DeMarco/DMH-BBDelay/Simulations/ch B.jpg

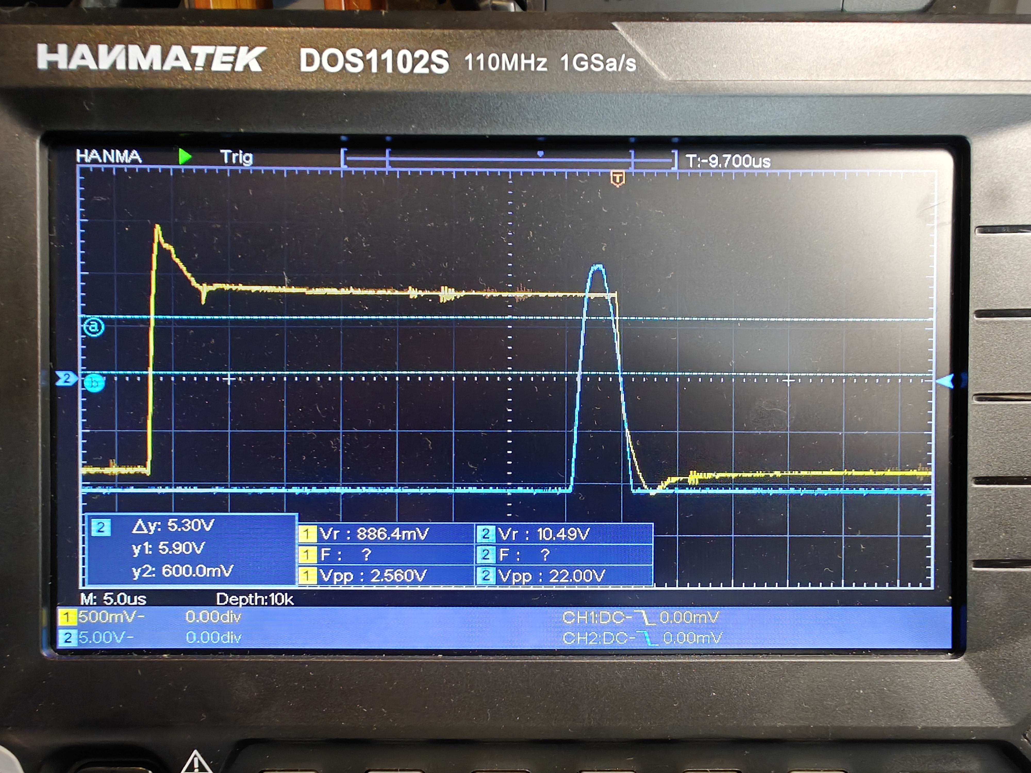
Simulations/ch B.jpg
