DeMarco/DMH-BBDelay/Simulations/ch A.jpg

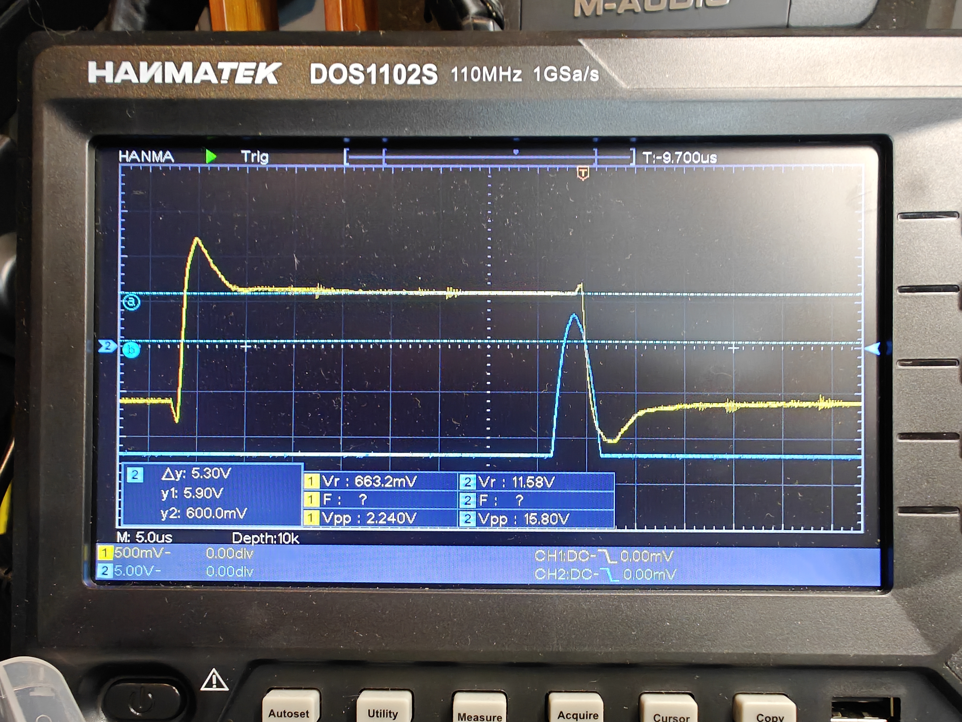
Simulations/ch A.jpg
