DeMarco/DMH-BBDelay/README.md

# DMH-BBDelay
Bucket Brigade Delay in Kosmo Format
