DeMarco/DMH-BBDelay/Simulations/ch A 2.jpg

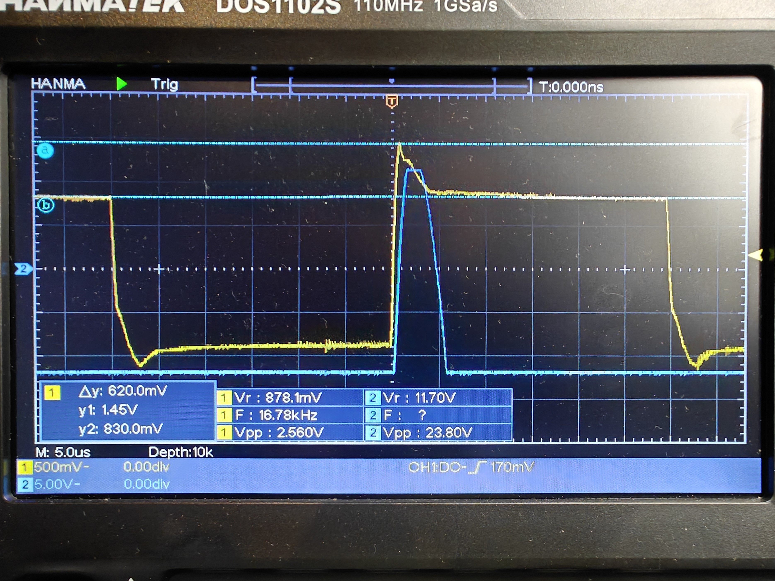
Simulations/ch A 2.jpg
