DeMarco/DMH-BBDelay/Simulations/ch B 2.jpg

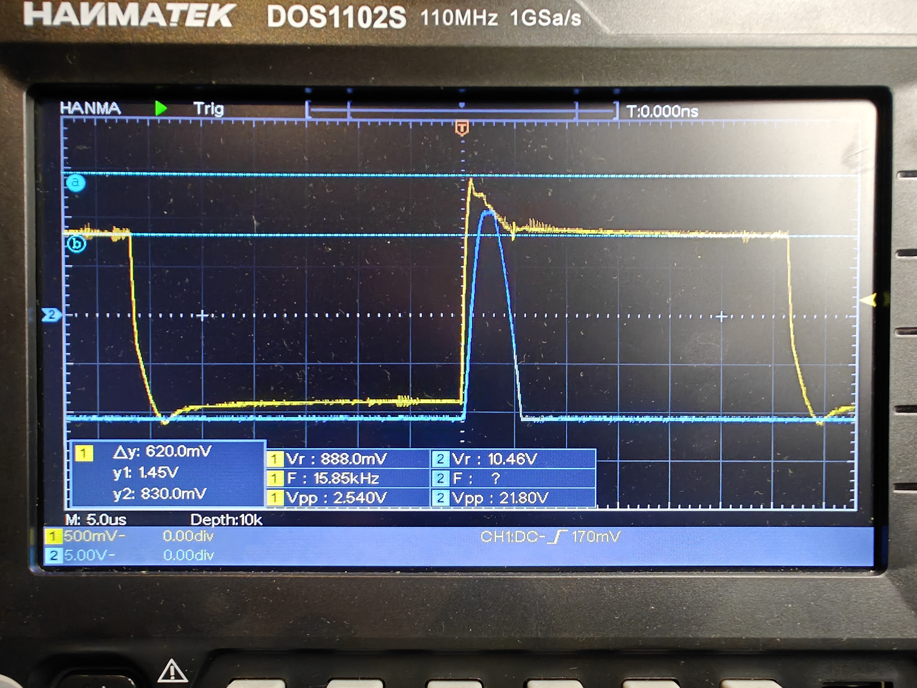
Simulations/ch B 2.jpg
