DeMarco/DMH-BBDelay/DMH_BBDelay_PCB_Main/DMH_BBDelay_PCB_Main.kicad_pcb

## KiCad design DMH_BBDelay_PCB_Main/DMH_BBDelay_PCB_Main.kicad_pcb (2026-11-13)

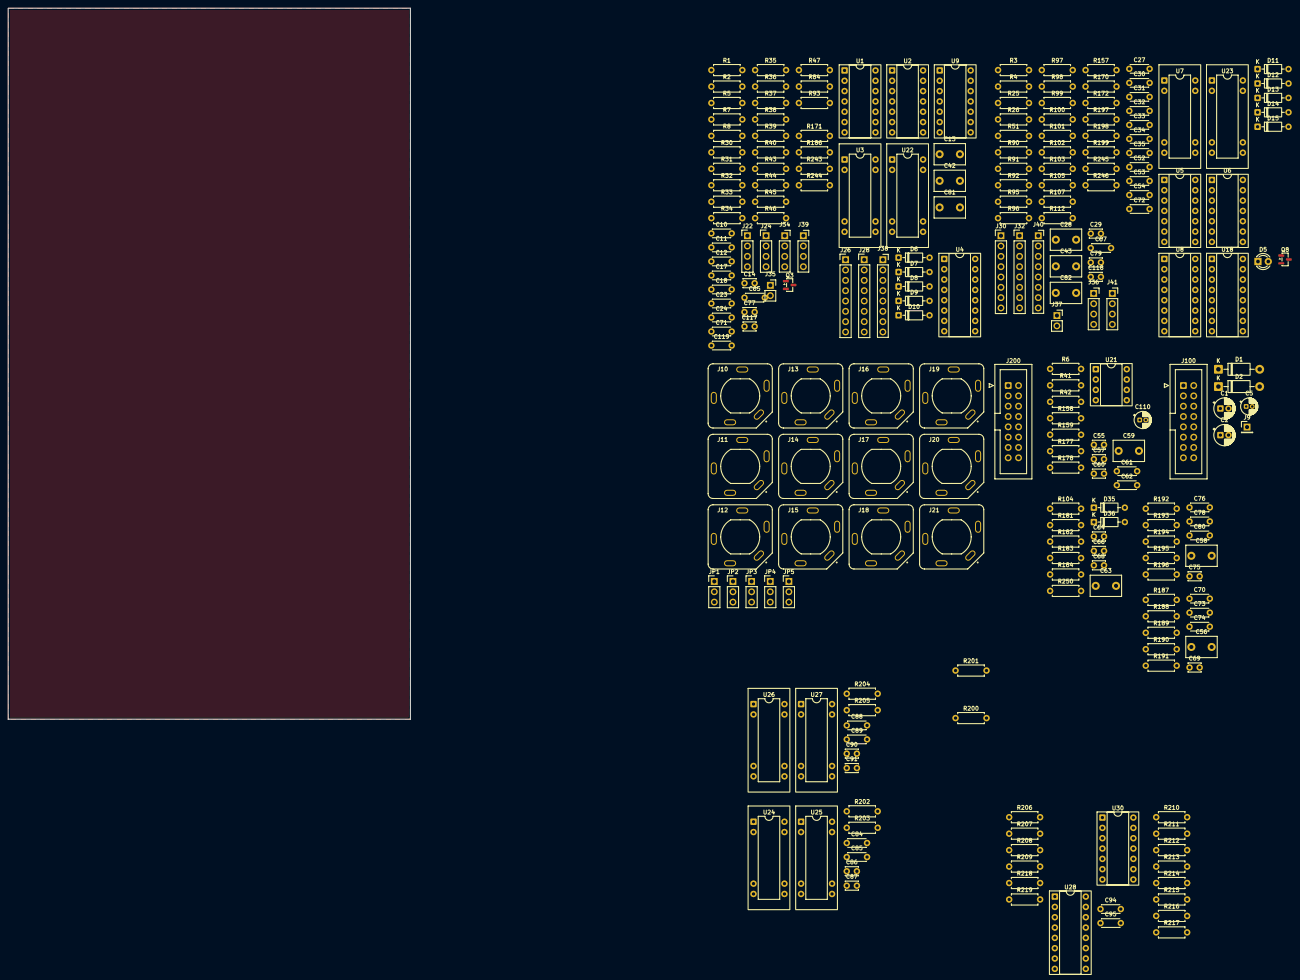
[picture p5: board DMH_BBDelay_PCB_Main.kicad_pcb from above]

Board: 2 copper layers, 99.0 x 175.0 mm, 236 parts (0 on the bottom side), 160 nets, no tracks yet.

Parts:
C1, C2: 47uF; CP_Radial_D5.0mm_P2.00mm
C5: 47uF; CP_Radial_D4.0mm_P1.50mm
C10, C11, C12, C18, C23, C24, C27, C30, C31, C33, C34, C35, C52, C53, C54, C61, C62, C65, C67, C71, C72, C84, C85, C88, C89, C94, C95: 100nF; C_Disc_D4.3mm_W1.9mm_P5.00mm
C13, C28, C42, C43, C56, C58, C59, C63, C81, C82: 1uF Film; C_Disc_D7.5mm_W5.0mm_P5.00mm
C14, C29: 220pF; C_Disc_D3.0mm_W2.0mm_P2.50mm
C17, C32: 15nF; C_Disc_D4.3mm_W1.9mm_P5.00mm
C55, C68: 150p; C_Disc_D3.0mm_W2.0mm_P2.50mm
C57, C60, C64, C66: 1.5nF; C_Disc_D3.0mm_W2.0mm_P2.50mm
C69, C75: 100p; C_Disc_D3.0mm_W2.0mm_P2.50mm
C70, C80: 1.5nF; C_Disc_D4.3mm_W1.9mm_P5.00mm
C73, C74, C76, C78: 1nF; C_Disc_D4.3mm_W1.9mm_P5.00mm
C77, C79, C86, C87, C90, C91: 470pF; C_Disc_D3.0mm_W2.0mm_P2.50mm
C110: 4.7uF; CP_Radial_D4.0mm_P1.50mm
C117, C118: 100pF; C_Disc_D3.0mm_W2.0mm_P2.50mm
C119: 3.3uF; C_Disc_D4.3mm_W1.9mm_P5.00mm
D1, D2: 1N5819; D_DO-41_SOD81_P10.16mm_Horizontal
D5: LED_Blue; LED_D3.0mm
D6, D15, D35, D36: 1N4148; D_DO-35_SOD27_P7.62mm_Horizontal
D7, D10, D12, D14: ZPD5v1; D_DO-35_SOD27_P7.62mm_Horizontal
D8, D9, D11, D13: BAT85; D_DO-35_SOD27_P7.62mm_Horizontal
J9: Conn_01x01; PinHeader_1x01_P2.54mm_Vertical
J10, J11, J12, J13, J14, J15, J16, J17, J18, J19, J20, J21: TRS_Jack_6.35mm_Sw; CUI_SJ-63083D
J22, J24: Conn_01x04; PinHeader_1x04_P2.54mm_Vertical
J26, J28, J30, J32: Conn_01x08; PinHeader_1x08_P2.54mm_Vertical
J34, J36, J39, J41: Conn_01x04; PinSocket_1x04_P2.54mm_Vertical
J35, J37: Conn_01x02; PinSocket_1x02_P2.54mm_Vertical
J38, J40: Conn_01x08; PinSocket_1x08_P2.54mm_Vertical
J100: IDC_02x08; IDC-Header_2x08_P2.54mm_Vertical_Eurorack
J200: IDC_02x08; IDC-Header_2x08_P2.54mm_Vertical_BackBone
JP1, JP2, JP3, JP4, JP5: Jumper_3_Bridged12; PinHeader_1x03_P2.54mm_Vertical
Q3, Q8: J113; SOT-23
R1, R3: 220k; R_Axial_DIN0207_L6.3mm_D2.5mm_P7.62mm_Horizontal
R2, R4, R5, R6, R25, R32, R33, R34, R37, R95, R96, R97, R101, R104, R170, R171, R172, R178, R183, R218, R219, R243, R246: 100k; R_Axial_DIN0207_L6.3mm_D2.5mm_P7.62mm_Horizontal
R7, R90: 3k3; R_Axial_DIN0207_L6.3mm_D2.5mm_P7.62mm_Horizontal
R8, R26: 2k2; R_Axial_DIN0207_L6.3mm_D2.5mm_P7.62mm_Horizontal
R30, R157: 4k7; R_Axial_DIN0207_L6.3mm_D2.5mm_P7.62mm_Horizontal
R31, R159, R182: 56k; R_Axial_DIN0207_L6.3mm_D2.5mm_P7.62mm_Horizontal
R35, R99: 5k6; R_Axial_DIN0207_L6.3mm_D2.5mm_P7.62mm_Horizontal
R36, R40, R44, R45, R51, R98, R102, R105: 10k; R_Axial_DIN0207_L6.3mm_D2.5mm_P7.62mm_Horizontal
R38: 14k; R_Axial_DIN0207_L6.3mm_D2.5mm_P7.62mm_Horizontal
R39, R92: 1M; R_Axial_DIN0207_L6.3mm_D2.5mm_P7.62mm_Horizontal
R41, R42, R200, R201, R202, R203, R204, R205, R244, R245: 20k; R_Axial_DIN0207_L6.3mm_D2.5mm_P7.62mm_Horizontal
R43, R84, R100, R112, R250: 1k; R_Axial_DIN0207_L6.3mm_D2.5mm_P7.62mm_Horizontal
R46, R47, R91, R103, R107, R189, R195: 39k; R_Axial_DIN0207_L6.3mm_D2.5mm_P7.62mm_Horizontal
R93: 15k8; R_Axial_DIN0207_L6.3mm_D2.5mm_P7.62mm_Horizontal
R158, R181: 47k; R_Axial_DIN0207_L6.3mm_D2.5mm_P7.62mm_Horizontal
R177, R184, R188, R196, R197, R207, R209, R211, R213, R215: 33k; R_Axial_DIN0207_L6.3mm_D2.5mm_P7.62mm_Horizontal
R186, R206, R208, R210, R212, R214: 6k8; R_Axial_DIN0207_L6.3mm_D2.5mm_P7.62mm_Horizontal
R187, R192: 120k; R_Axial_DIN0207_L6.3mm_D2.5mm_P7.62mm_Horizontal
R190, R191, R193, R194: 43k; R_Axial_DIN0207_L6.3mm_D2.5mm_P7.62mm_Horizontal
R198, R199, R216, R217: 75R; R_Axial_DIN0207_L6.3mm_D2.5mm_P7.62mm_Horizontal
U1, U2, U5, U6, U30: TL074; DIP-14_W7.62mm_Socket
U3, U7, U22, U23, U24, U25, U26, U27: V3205; DIP-8-16_W7.62mm_Socket
U4, U8: CD4046; DIP-16_W7.62mm_Socket
U9: 40106; DIP-14_W7.62mm_Socket
U18, U28: CD4053B; DIP-16_W7.62mm_Socket
U21: TL072; DIP-8_W7.62mm_Socket

Connections:
+5V: C5.1, C12.2, C18.1, C27.2, C35.2, C52.1, C71.1, C72.2, C84.1, C85.1, C88.1, C89.1, J22.1, J100.6a, J100.6b, R30.2, R41.2, R197.2, R207.2, R209.2, R211.2, R213.2, R215.2, U3.5 (Vdd), U4.14 (SigIn), U4.16 (VDD), U7.5 (Vdd), U8.14 (SigIn), U8.16 (VDD), U9.14 (VDD), U22.5 (Vdd), U23.5 (Vdd), U24.5 (Vdd), U25.5 (Vdd), U26.5 (Vdd), U27.5 (Vdd)
+12V: C2.1, C10.1, C23.1, C30.1, C33.1, C53.1, C61.1, C65.1, C94.1, D2.1 (K), J22.2, J35.1, J37.1, J39.2, J41.2, R37.1, R97.1, R157.1, R170.2, R218.2, R219.2, U1.4 (V+), U2.4 (V+), U5.4 (V+), U6.4 (V+), U18.16 (VDD), U21.8 (V+), U28.16 (VDD), U30.4 (V+)
-12V: C1.2, C11.2, C24.2, C31.2, C34.2, C54.1, C62.2, C67.2, C95.1, D1.2 (A), J22.3, J35.2, J37.2, J39.3, J41.3, R46.2, R93.1, R103.2, U1.11 (V-), U2.11 (V-), U5.11 (V-), U6.11 (V-), U18.7 (VEE), U21.4 (V-), U28.7 (VEE), U30.11 (V-)
/Core Circuit A/Input Filter A/Out: C55.2, R178.2, U21.1, U28.12 (A0)
/Core Circuit A/VCXF_DW_A/Out_X: C81.1, J38.8
/Core Circuit B/Input Filter B/In: C118.2, R90.2, R250.1, U5.7
/Core Circuit B/Input Filter B/Out: C68.2, R183.2, U7.7 (In), U21.7
/Core Circuit B/Output Filter B/In: C58.1, R246.2, U6.8
/Core Circuit B/VCXF_DW_B/Out_X: C82.1, J40.8
A_In_m: C42.1, J10.T (3), JP1.3 (B), R1.2
BBD_A1_Out_m: R186.1, U3.4 (Out2), U28.5 (C0)
BBD_A4_Out_m: U25.4 (Out2), U28.3 (C1)
B_In_m: C43.1, J16.T (3), R3.2
Clock_A_Inv_m: C14.1, J28.1, R198.2, U3.2 (CP2), U22.6 (CP1), U24.2 (CP2), U25.6 (CP1)
Clock_A_m: J26.4, U4.3 (RefIn), U4.4 (FOUT), U30.3 (+)
Clock_B_Inv_m: C29.1, J32.1, R217.2, U7.2 (CP2), U23.6 (CP1), U26.2 (CP2), U27.6 (CP1)
Clock_B_m: J30.4, U8.4 (FOUT)
Clock_Cap1_B_m: J30.5, U8.6 (C1)
Clock_Cap2_B_m: J30.6, U8.7 (C2)
DW_A_CV_In_m: J12.T (3), J28.7, J38.5, JP2.3 (B)
DW_A_CV_Pot_m: J28.6, J38.6
DW_A_Out_m: J11.T (3), J200.2, R84.2
DW_A_Pot_m: J28.8, J38.7
DW_B_CV_In_m: J18.T (3), J32.7, J40.5
DW_B_CV_Pot_m: J32.6, J40.6
DW_B_Out_m: J17.T (3), J200.10, R112.2
DW_B_Pot_m: J32.8, J40.7
Dry_A_Buff_m: C59.1, J26.3, J38.1, R6.2, U1.1, U1.2 (-), U28.13 (A1)
Dry_B_Buff_Sw_m: R25.2, U18.4 (C)
Dry_B_Buff_m: J30.3, U5.1, U5.2 (-), U18.3 (C1)
FB_A_CV_In_m: J14.T (3), J28.3, JP4.3 (B)
FB_A_CV_Proc_m: J28.2, J34.2
FB_B_CV_In_m: J20.T (3), J32.3
FB_B_CV_Proc_m: J32.2, J36.2
GND: C1.1, C2.2, C5.2, C10.2, C11.1, C12.1, C17.1, C18.2, C23.2, C24.1, C27.1, C30.2, C31.1, C32.1, C33.2, C34.1, C35.1, C52.2, C53.2, C54.2, C57.1, C60.1, C61.2, C62.1, C64.1, C65.2, C66.1, C67.1, C70.1, C71.2, C72.1, C73.1, C74.1, C76.1, C77.1, C78.1, C79.1, C80.1, C84.2, C85.2, C86.1, C87.1, C88.2, C89.2, C90.1, C91.1, C94.2, C95.2, C110.2, C119.1, D7.2 (A), D8.2 (A), D9.2 (A), D10.2 (A), D11.2 (A), D12.2 (A), D13.2 (A), D14.2 (A), D35.2 (A), D36.1 (K), J9.1 (Pin_1_1), J10.S (1), J11.S (1), J12.S (1), J13.S (1), J14.S (1), J15.S (1), J16.S (1), J17.S (1), J18.S (1), J19.S (1), J20.S (1), J21.S (1), J22.4, J24.1, J24.2, J24.3, J24.4, J30.1, J34.4, J36.4, J39.1, J39.4, J41.1, J41.4, J100.2a, J100.2b, J100.3a, J100.3b, J100.4a, J100.4b, J200.7, J200.8, J200.15, J200.16, R1.1, R2.1, R3.1, R4.1, R6.1, R31.1, R32.1, R33.1, R35.1, R36.1, R38.1, R39.1, R42.1, R91.1, R92.1, R95.1, R96.1, R98.1, R99.1, R104.1, R171.1, R172.1, R200.1, R201.1, R202.1, R203.1, R204.1, R205.1, R244.1, R245.1, U1.5 (+), U2.3 (+), U2.5 (+), U2.12 (+), U3.1 (GND), U4.8 (VSS), U5.5 (+), U6.3 (+), U6.5 (+), U6.12 (+), U7.1 (GND), U8.8 (VSS), U9.5, U9.7 (VSS), U9.9, U18.6 (INH), U18.8 (VSS), U21.3 (+), U22.1 (GND), U23.1 (GND), U24.1 (GND), U25.1 (GND), U26.1 (GND), U27.1 (GND), U28.6 (INH), U28.8 (VSS)
In_Mix_A_m: C117.1, R5.2, R7.1, R8.1, R93.2, U1.6 (-)
Inhibit_A_CV_m: J15.T (3), JP5.3 (B), R40.1, R171.2
Inhibit_B_CV_m: J21.T (3), R51.1, R172.2
Link_Sw_m: J30.2, U8.3 (RefIn), U30.12 (+)
unnamed: C56.2, R191.1
unnamed: C57.2, R159.2, R177.1, R178.1
unnamed: C58.2, R193.1
unnamed: C59.2, R158.1
unnamed: C60.2, R158.2, R159.1
unnamed: C63.2, R181.1
unnamed: C64.2, R181.2, R182.1
unnamed: C66.2, R182.2, R183.1, R184.1
unnamed: C70.2, R187.1, R188.1, R189.2
unnamed: C73.2, R189.1, R190.2
unnamed: C74.2, R190.1, R191.2
unnamed: C76.2, R193.2, R194.1
unnamed: C78.2, R194.2, R195.1
unnamed: C80.2, R192.1, R195.2, R196.1
unnamed: C81.2, R84.1
unnamed: C82.2, R112.1
unnamed: D1.1 (K), J100.1a, J100.1b
unnamed: D2.2 (A), J100.5a, J100.5b
unnamed: D5.2 (A), R157.2
unnamed: D6.2 (A), Q3.3 (G), R34.1
unnamed: D6.1 (K), U1.14
unnamed: D7.1 (K), D8.1 (K), R40.2, U9.11
unnamed: D9.1 (K), D10.1 (K), R43.1, U4.9 (VCOin)
unnamed: D11.1 (K), D12.1 (K), R51.2, U9.3
unnamed: D13.1 (K), D14.1 (K), R100.1, U8.9 (VCOin)
unnamed: D15.2 (A), Q8.3 (G), R101.1
unnamed: D15.1 (K), U5.14
unnamed: C63.1, D35.1 (K), D36.2 (A), R104.2, R250.2
unnamed: J10.TN (2), J200.1
unnamed: J12.TN (2), J200.3
unnamed: J13.TN (2), J200.4
unnamed: J14.TN (2), J200.5
unnamed: J15.TN (2), J200.6
unnamed: J16.TN (2), JP1.2 (C)
unnamed: J18.TN (2), JP2.2 (C)
unnamed: J19.TN (2), JP3.2 (C)
unnamed: J20.TN (2), JP4.2 (C)
unnamed: J21.TN (2), JP5.2 (C)
unnamed: J100.7a, J100.7b
unnamed: J100.8a, J100.8b
unnamed: J200.9, JP1.1 (A)
unnamed: J200.11, JP2.1 (A)
unnamed: J200.12, JP3.1 (A)
unnamed: J200.13, JP4.1 (A)
unnamed: J200.14, JP5.1 (A)
unnamed: Q3.1 (D), R34.2, U1.8, U1.9 (-)
unnamed: C17.2, Q3.2 (S), U2.10 (+)
unnamed: Q8.1 (D), R101.2, U5.8, U5.9 (-)
unnamed: C32.2, Q8.2 (S), U6.10 (+)
unnamed: R43.2, R44.1, U2.1
unnamed: R45.2, R47.1, U2.7
unnamed: R100.2, R102.1, U6.1
unnamed: R105.2, R107.1, U6.7
unnamed: C42.2, R2.2, U1.3 (+)
unnamed: C13.2, R33.2, U1.10 (+)
unnamed: C14.2, R35.2, U1.12 (+)
unnamed: R36.2, R37.2, U1.13 (-)
unnamed: R44.2, R45.1, R46.1, U2.2 (-)
unnamed: R243.1, R244.2, U2.9 (-)
unnamed: C69.1, R188.2, U2.13 (-)
unnamed: C117.2, R7.2, U1.7, U3.7 (In)
unnamed: U4.5 (Inh), U9.12
unnamed: R38.2, U4.11 (R1)
unnamed: R39.2, U4.12 (R2)
unnamed: C43.2, R4.2, U5.3 (+)
unnamed: C118.1, R25.1, R26.1, R90.1, U5.6 (-)
unnamed: C28.2, R96.2, U5.10 (+)
unnamed: C29.2, R99.2, U5.12 (+)
unnamed: R97.2, R98.2, U5.13 (-)
unnamed: R102.2, R103.1, R105.1, U6.2 (-)
unnamed: R245.2, R246.1, U6.9 (-)
unnamed: C75.1, R196.2, U6.13 (-)
unnamed: R210.1, U7.4 (Out2)
unnamed: U8.5 (Inh), U9.2
unnamed: R91.2, U8.11 (R1)
unnamed: R92.2, U8.12 (R2)
unnamed: U9.1, U9.4
unnamed: U9.10, U9.13
unnamed: C55.1, R177.2, U21.2 (-)
unnamed: C68.1, R184.2, U21.6 (-)
unnamed: R199.2, U3.6 (CP1), U22.2 (CP2), U24.6 (CP1), U25.2 (CP2)
unnamed: C77.2, R186.2, R197.1, R200.2, U22.7 (In)
unnamed: R206.1, U22.4 (Out2)
unnamed: R216.2, U7.6 (CP1), U23.2 (CP2), U26.6 (CP1), U27.2 (CP2)
unnamed: C79.2, R201.2, R210.2, R211.1, U23.7 (In)
unnamed: R214.1, U23.4 (Out2)
unnamed: C86.2, R202.2, R206.2, R207.1, U24.7 (In)
unnamed: R208.1, U24.4 (Out2)
unnamed: C87.2, R203.2, R208.2, R209.1, U25.7 (In)
unnamed: C90.2, R204.2, R214.2, R215.1, U26.7 (In)
unnamed: R212.1, U26.4 (Out2)
unnamed: C91.2, R205.2, R212.2, R213.1, U27.7 (In)
unnamed: C28.1, R95.2, U27.4 (Out2)
unnamed: R5.1, U28.14 (A)
unnamed: R199.1, U30.1, U30.2 (-)
unnamed: U4.2 (PC1), U30.5 (+)
unnamed: R198.1, U30.6 (-), U30.7
unnamed: U8.2 (PC1), U30.10 (+)
unnamed: R217.1, U30.8, U30.9 (-)
unnamed: R216.1, U30.13 (-), U30.14
OF_A_In_m: C56.1, R243.2, U2.8, U28.1 (B1)
OF_A_Out_m: C69.2, R187.2, U2.14, U28.2 (B0)
PP_Sw_p2_m: J26.2, J40.1
PP_Sw_p5_m: D5.1 (K), J26.1, R170.1, U18.9 (S3), U18.10 (S2), U18.11 (S1)
Ref_2v5: C110.1, R41.1, R42.2, U21.5 (+)
Rng_A_Sw_p1_m: J26.6, R219.1, U28.9 (S3)
Rng_A_Sw_p3_m: J26.5, R218.1, U28.10 (S2), U28.11 (S1)
SH_A_In_m: C13.1, R32.2, U28.4 (C)
Time_A_CV_In_m: J13.T (3), J28.5, JP3.3 (B)
Time_A_CV_Proc_m: J28.4, R47.2, U2.6 (-)
Time_B_CV_In_m: J19.T (3), J32.5
Time_B_CV_Proc_m: J32.4, R107.2, U6.6 (-)
VCA_FB_A_In_m: J34.1, U18.14 (A)
VCA_FB_A_Out_m: J34.3, R8.2
VCA_FB_B_In_m: J36.1, U18.15 (B)
VCA_FB_B_Out_m: J36.3, R26.2
VGG_m: C119.2, R30.1, R31.2, U3.8 (Vgg), U7.8 (Vgg), U22.8 (Vgg), U23.8 (Vgg), U24.8 (Vgg), U25.8 (Vgg), U26.8 (Vgg), U27.8 (Vgg)
Wet_A_Out_m: J26.7, U18.2 (B0), U18.13 (A1), U28.15 (B)
Wet_A_TC_Out_m: J26.8, J38.3
Wet_B_Out_m: C75.2, J30.7, R192.2, U6.14, U18.1 (B1), U18.12 (A0)
Wet_B_TC_Out_m: J30.8, J40.3
