DeMarco/DMH-BBDelay/Simulations/Input_Filter/Input_Filter.kicad_sch

## KiCad design Simulations/Input_Filter/Input_Filter.kicad_sch (2026-10-10)

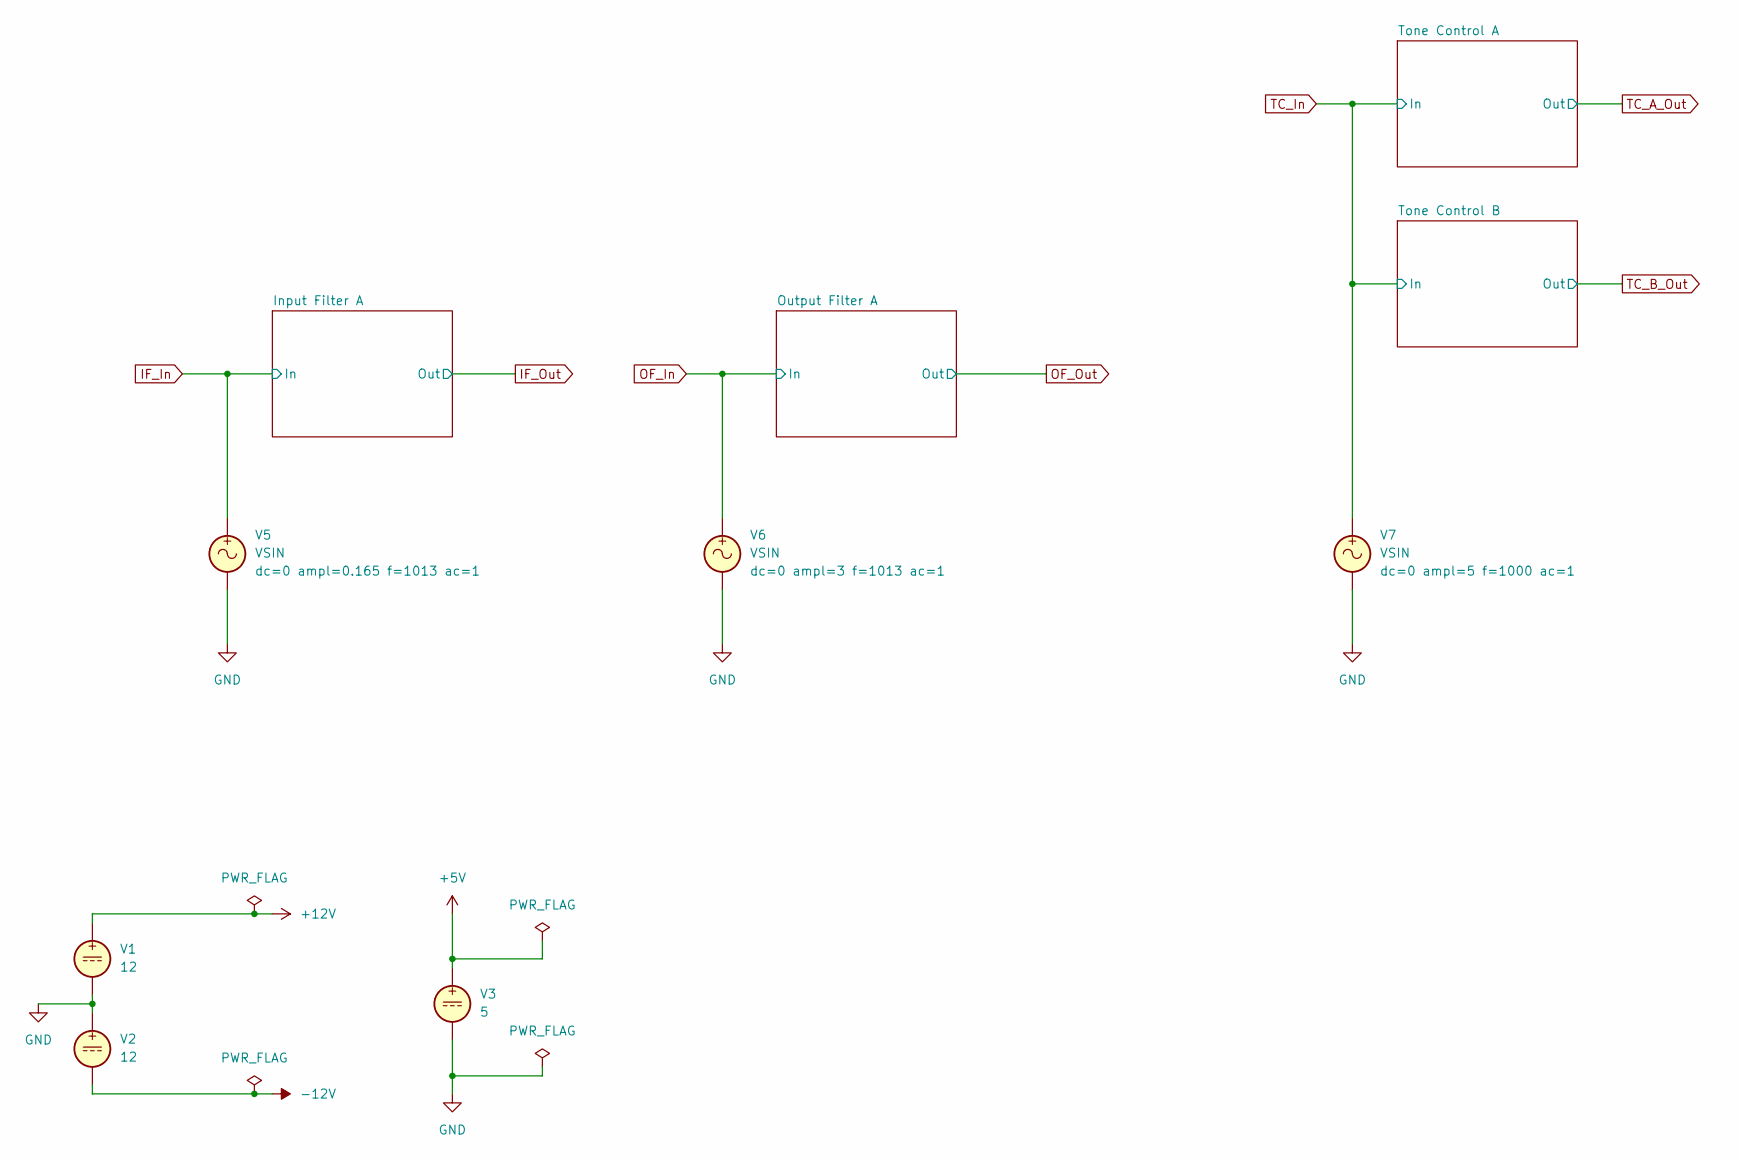
[picture p6: schematic Input_Filter.kicad_sch]

Parts:
V1, V2: 12
V3: 5
V5, V6, V7: VSIN

Connections:
+5V: V3.1
+12V: V1.1
-12V: V2.2
GND: V1.2, V2.1, V3.2, V5.2, V6.2, V7.2
IF_In: V5.1
OF_In: V6.1
TC_In: V7.1
