DeMarco/DMH-BBDelay/Simulations/Input_Filter/Input_filter_A.kicad_sch

## KiCad design Simulations/Input_Filter/Input_filter_A.kicad_sch (2026-10-10)

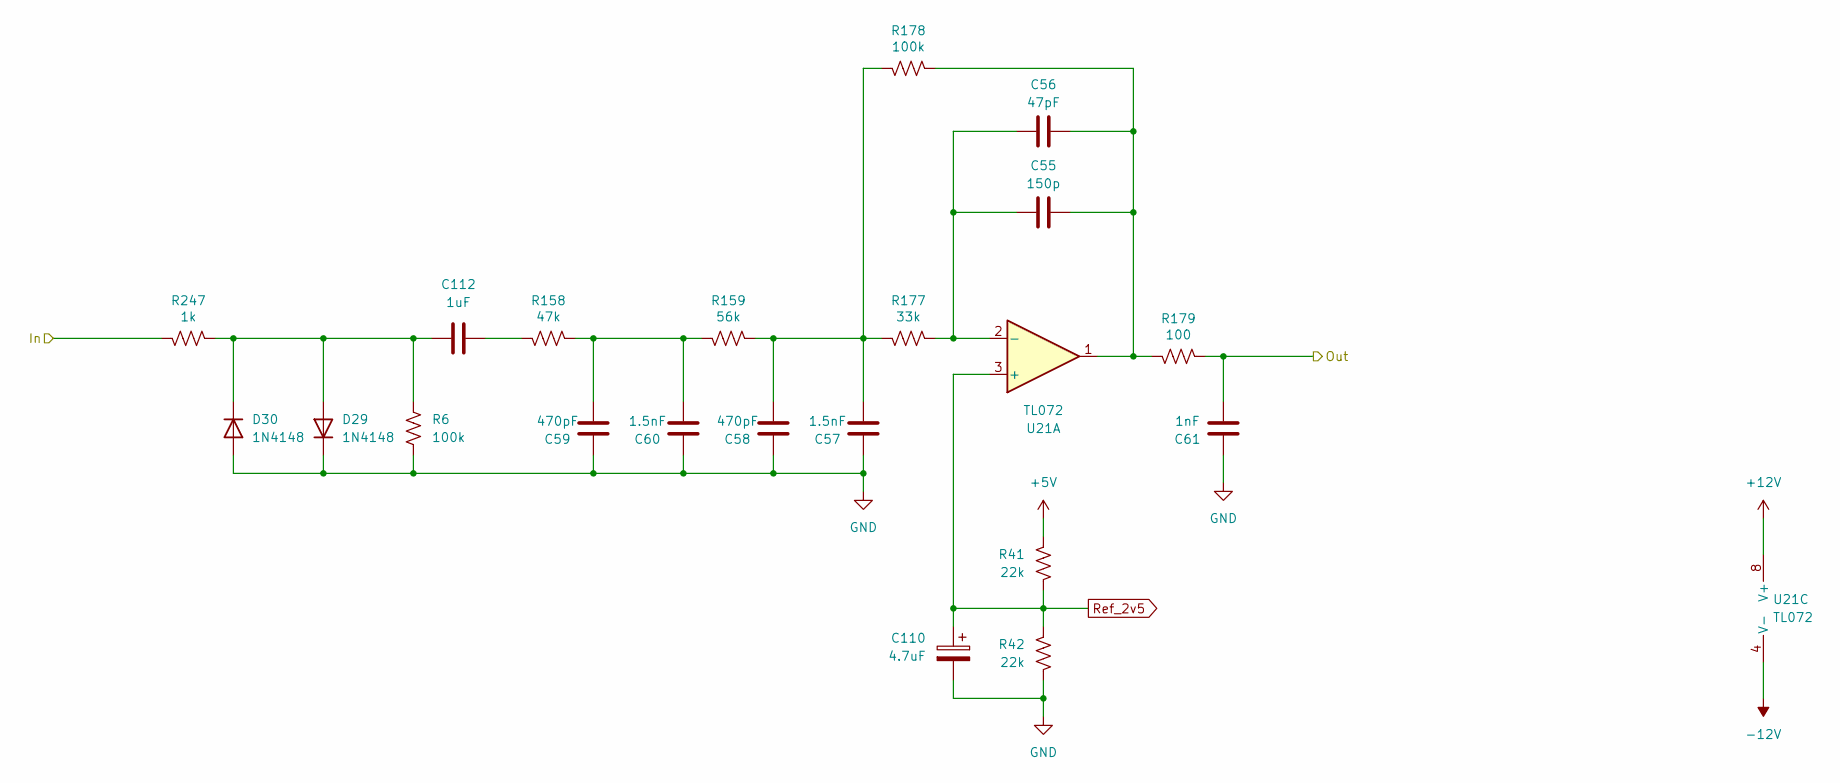
[picture p7: schematic Input_filter_A.kicad_sch]

Parts:
C55: 150p; C_Disc_D3.0mm_W2.0mm_P2.50mm
C56: 47pF; C_Disc_D3.0mm_W2.0mm_P2.50mm
C57, C60: 1.5nF; C_Disc_D3.0mm_W2.0mm_P2.50mm
C58, C59: 470pF; C_Disc_D3.0mm_W2.0mm_P2.50mm
C61: 1nF; C_Disc_D3.0mm_W2.0mm_P2.50mm
C110: 4.7uF; CP_Radial_D4.0mm_P1.50mm
C112: 1uF; C_Disc_D4.3mm_W1.9mm_P5.00mm
D29, D30: 1N4148; D_DO-35_SOD27_P7.62mm_Horizontal
R6, R178: 100k; R_Axial_DIN0207_L6.3mm_D2.5mm_P7.62mm_Horizontal
R41, R42: 22k; R_Axial_DIN0207_L6.3mm_D2.5mm_P7.62mm_Horizontal
R158: 47k; R_Axial_DIN0207_L6.3mm_D2.5mm_P7.62mm_Horizontal
R159: 56k; R_Axial_DIN0207_L6.3mm_D2.5mm_P7.62mm_Horizontal
R177: 33k; R_Axial_DIN0207_L6.3mm_D2.5mm_P7.62mm_Horizontal
R179: 100; R_Axial_DIN0207_L6.3mm_D2.5mm_P7.62mm_Horizontal
R247: 1k; R_Axial_DIN0207_L6.3mm_D2.5mm_P7.62mm_Horizontal
U21: TL072; DIP-8_W7.62mm_Socket

Connections:
+5V: R41.2
+12V: U21.8 (V+)
-12V: U21.4 (V-)
GND: C57.1, C58.1, C59.1, C60.1, C61.1, C110.2, D29.1 (K), D30.2 (A), R6.1, R42.1
In: R247.1
unnamed: C55.1, C56.1, R177.2, U21.2 (-)
unnamed: C55.2, C56.2, R178.2, R179.1, U21.1
unnamed: C57.2, C58.2, R159.2, R177.1, R178.1
unnamed: C59.2, C60.2, R158.2, R159.1
unnamed: C112.1, D29.2 (A), D30.1 (K), R6.2, R247.2
unnamed: C112.2, R158.1
Out: C61.2, R179.2
Ref_2v5: C110.1, R41.1, R42.2, U21.3 (+)
