DeMarco/DMH-BBDelay/Simulations/Input_Filter/Output_filter_A.kicad_sch

## KiCad design Simulations/Input_Filter/Output_filter_A.kicad_sch (2026-10-09)

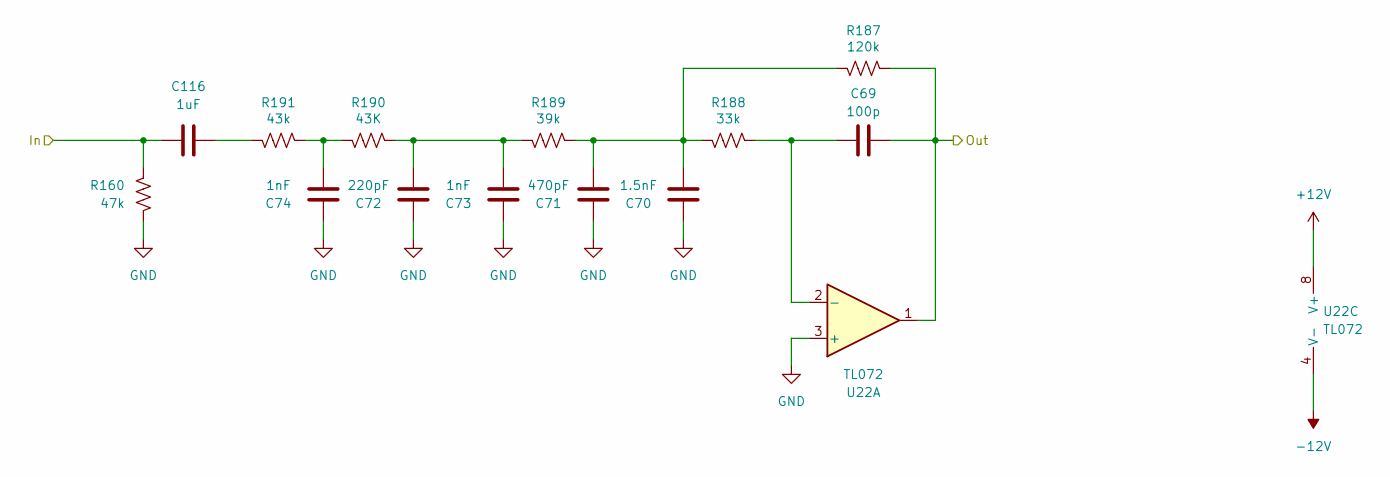
[picture p8: schematic Output_filter_A.kicad_sch]

Parts:
C69: 100p; C_Disc_D3.0mm_W2.0mm_P2.50mm
C70: 1.5nF; C_Disc_D4.3mm_W1.9mm_P5.00mm
C71: 470pF; C_Disc_D4.3mm_W1.9mm_P5.00mm
C72: 220pF; C_Disc_D4.3mm_W1.9mm_P5.00mm
C73, C74: 1nF; C_Disc_D4.3mm_W1.9mm_P5.00mm
C116: 1uF; C_Disc_D4.3mm_W1.9mm_P5.00mm
R160: 47k; R_Axial_DIN0207_L6.3mm_D2.5mm_P7.62mm_Horizontal
R187: 120k; R_Axial_DIN0207_L6.3mm_D2.5mm_P7.62mm_Horizontal
R188: 33k; R_Axial_DIN0207_L6.3mm_D2.5mm_P7.62mm_Horizontal
R189: 39k; R_Axial_DIN0207_L6.3mm_D2.5mm_P7.62mm_Horizontal
R190: 43K; R_Axial_DIN0207_L6.3mm_D2.5mm_P7.62mm_Horizontal
R191: 43k; R_Axial_DIN0207_L6.3mm_D2.5mm_P7.62mm_Horizontal
U22: TL072; DIP-8_W7.62mm_Socket

Connections:
+12V: U22.8 (V+)
-12V: U22.4 (V-)
GND: C70.1, C71.1, C72.1, C73.1, C74.1, R160.1, U22.3 (+)
In: C116.1, R160.2
unnamed: C69.1, R188.2, U22.2 (-)
unnamed: C70.2, C71.2, R187.1, R188.1, R189.2
unnamed: C72.2, C73.2, R189.1, R190.2
unnamed: C74.2, R190.1, R191.2
unnamed: C116.2, R191.1
Out: C69.2, R187.2, U22.1
