DeMarco/DMH-BBDelay/Simulations/Input_Filter/Power.kicad_sch

## KiCad design Simulations/Input_Filter/Power.kicad_sch (2026-09-22)

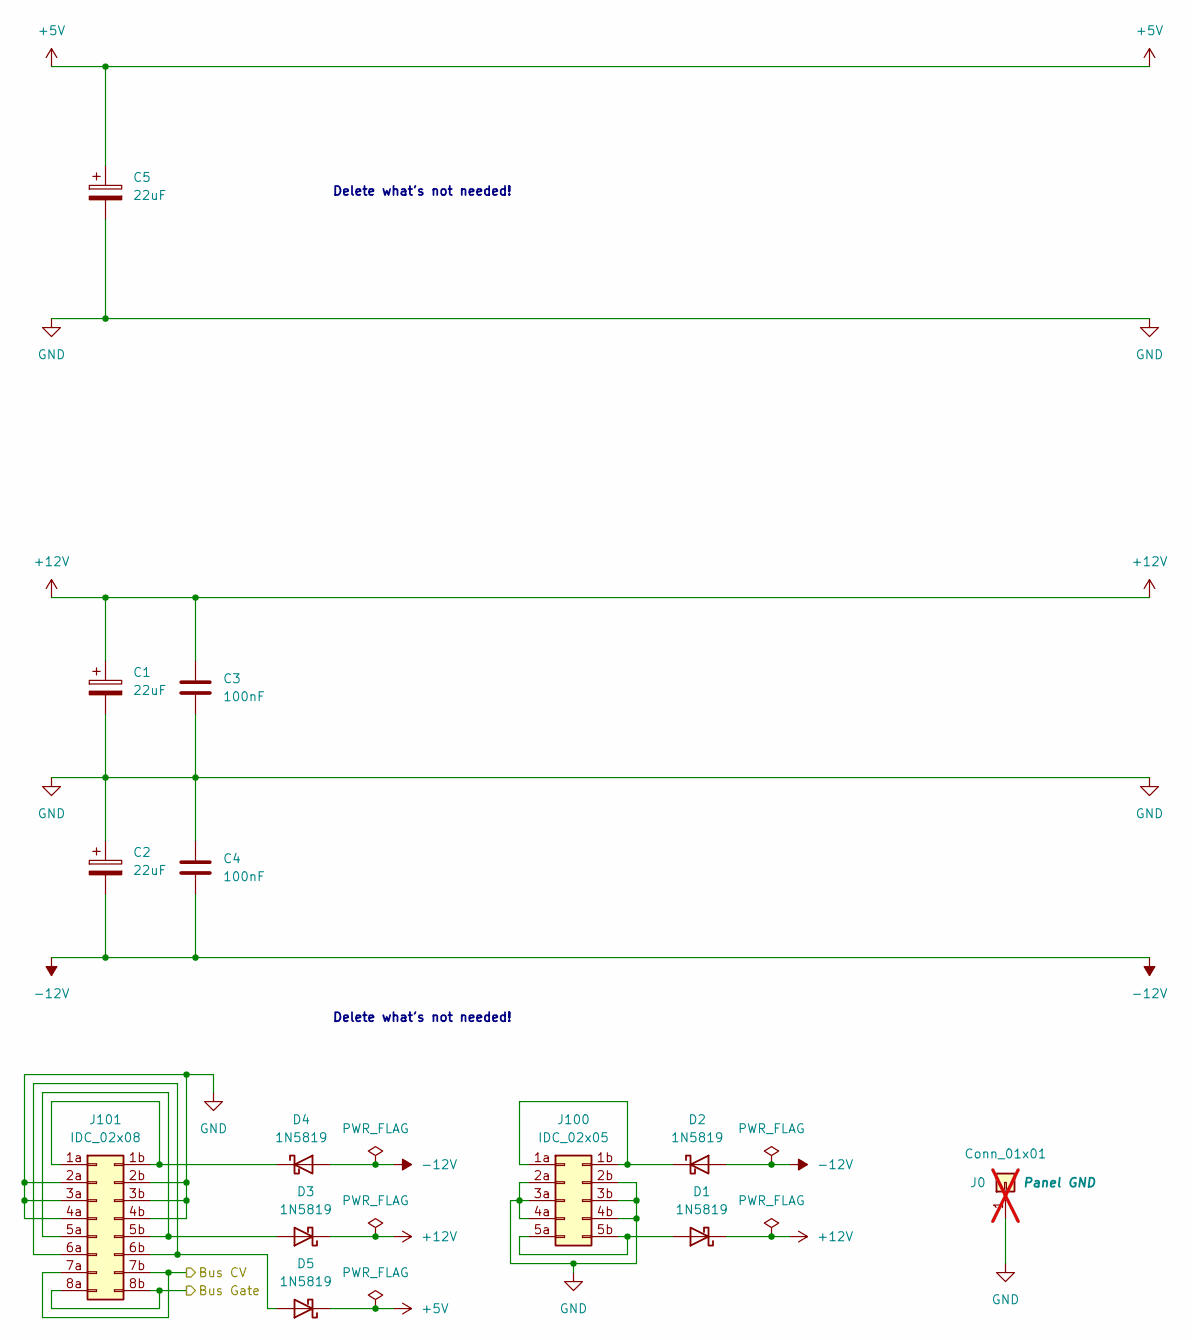
[picture p9: schematic Power.kicad_sch]

Parts:
C1, C2: 22uF; CP_Radial_D5.0mm_P2.00mm
C3, C4: 100nF; C_Disc_D4.3mm_W1.9mm_P5.00mm
C5: 22uF; CP_Radial_D4.0mm_P1.50mm
D1, D2, D3, D4, D5: 1N5819; D_DO-41_SOD81_P10.16mm_Horizontal
J0: Conn_01x01; PinHeader_1x01_P2.54mm_Vertical; not fitted
J100: IDC_02x05; IDC-Header_2x05_P2.54mm_Vertical_Eurorack
J101: IDC_02x08; IDC-Header_2x08_P2.54mm_Vertical_Eurorack

Connections:
+5V: C5.1, D5.1 (K)
+12V: C1.1, C3.1, D1.1 (K), D3.1 (K)
-12V: C2.2, C4.2, D2.2 (A), D4.2 (A)
Bus CV: J101.7a, J101.7b
Bus Gate: J101.8a, J101.8b
GND: C1.2, C2.1, C3.2, C4.1, C5.2, J0.1, J100.2a, J100.2b, J100.3a, J100.3b, J100.4a, J100.4b, J101.2a, J101.2b, J101.3a, J101.3b, J101.4a, J101.4b
unnamed: D1.2 (A), J100.5a, J100.5b
unnamed: D2.1 (K), J100.1a, J100.1b
unnamed: D3.2 (A), J101.5a, J101.5b
unnamed: D4.1 (K), J101.1a, J101.1b
unnamed: D5.2 (A), J101.6a, J101.6b

Notes on the sheet:
Delete what's not needed!
