DeMarco/DMH-BBDelay/Simulations/Input_Filter/Tone_Control_A.kicad_sch

## KiCad design Simulations/Input_Filter/Tone_Control_A.kicad_sch (2026-10-01)

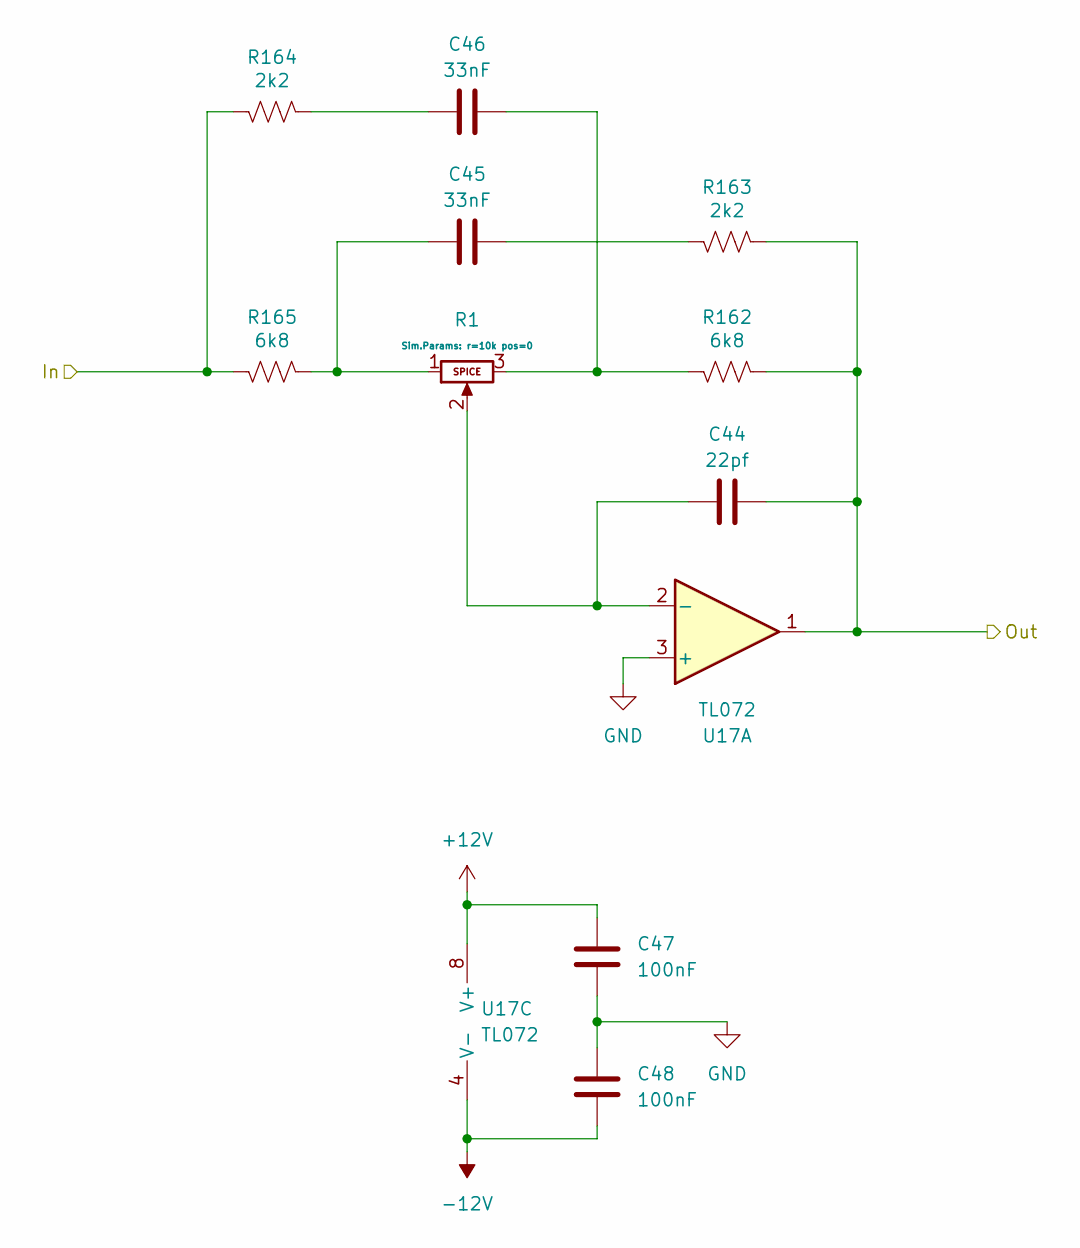
[picture p10: schematic Tone_Control_A.kicad_sch]

Parts:
C44: 22pf; C_Disc_D3.0mm_W2.0mm_P2.50mm
C45, C46: 33nF; C_Disc_D4.3mm_W1.9mm_P5.00mm
C47, C48: 100nF; C_Disc_D4.3mm_W1.9mm_P5.00mm
R1: Potentiometer
R162, R165: 6k8; R_Axial_DIN0207_L6.3mm_D2.5mm_P7.62mm_Horizontal
R163, R164: 2k2; R_Axial_DIN0207_L6.3mm_D2.5mm_P7.62mm_Horizontal
U17: TL072; DIP-8_W7.62mm_Socket

Connections:
+12V: C47.1, U17.8 (V+)
-12V: C48.2, U17.4 (V-)
GND: C47.2, C48.1, U17.3 (+)
In: R164.1, R165.1
unnamed: C44.1, R1.2, U17.2 (-)
unnamed: C45.1, R1.1, R165.2
unnamed: C45.2, R163.1
unnamed: C46.1, R164.2
unnamed: C46.2, R1.3, R162.1
Out: C44.2, R162.2, R163.2, U17.1
