DeMarco/DMH-BBDelay/Simulations/Input_Filter/Tone_Control_B.kicad_sch

## KiCad design Simulations/Input_Filter/Tone_Control_B.kicad_sch (2026-10-01)

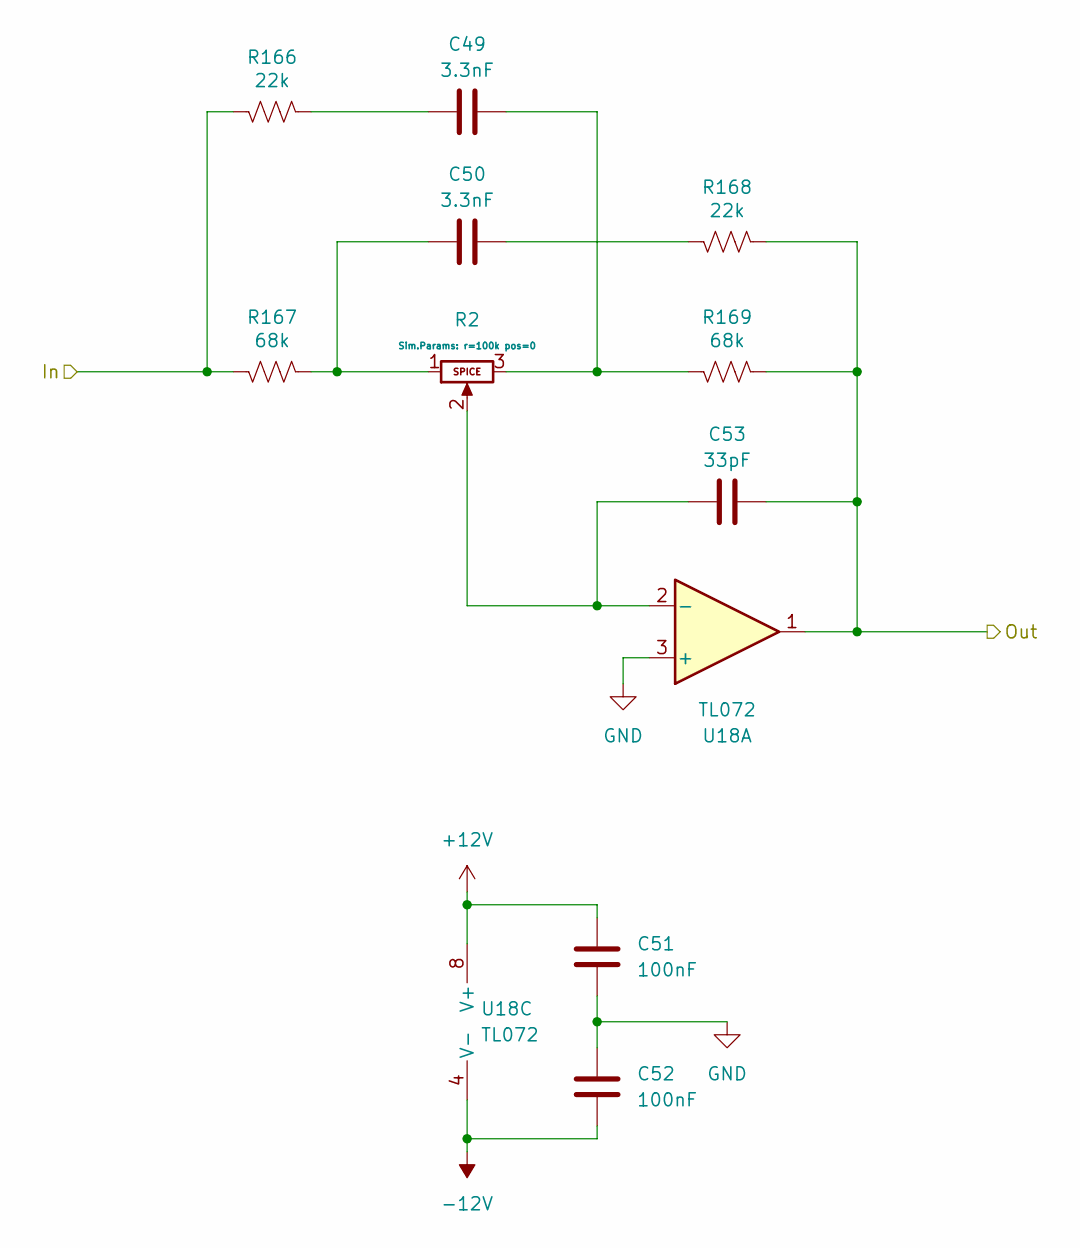
[picture p11: schematic Tone_Control_B.kicad_sch]

Parts:
C49, C50: 3.3nF; C_Disc_D4.3mm_W1.9mm_P5.00mm
C51, C52: 100nF; C_Disc_D4.3mm_W1.9mm_P5.00mm
C53: 33pF; C_Disc_D3.0mm_W2.0mm_P2.50mm
R2: Potentiometer
R166, R168: 22k; R_Axial_DIN0207_L6.3mm_D2.5mm_P7.62mm_Horizontal
R167, R169: 68k; R_Axial_DIN0207_L6.3mm_D2.5mm_P7.62mm_Horizontal
U18: TL072; DIP-8_W7.62mm_Socket

Connections:
+12V: C51.1, U18.8 (V+)
-12V: C52.2, U18.4 (V-)
GND: C51.2, C52.1, U18.3 (+)
In: R166.1, R167.1
unnamed: C49.1, R166.2
unnamed: C49.2, R2.3, R169.1
unnamed: C50.1, R2.1, R167.2
unnamed: C50.2, R168.1
unnamed: C53.1, R2.2, U18.2 (-)
Out: C53.2, R168.2, R169.2, U18.1
