DeMarco/DMH-BBDelay/(commit log)

2025-12-26 Created Panel project
    ... and did initial design
    [DMH_BBDelay_PANEL.kicad_pcb, DMH_BBDelay_PANEL.kicad_sch]
2025-12-27 FInalized panel design
    [DMH_BBDelay_PANEL.kicad_pcb, DMH_BBDelay_PANEL.kicad_sch]
2025-12-28 Added LEDs and Link switch
    [DMH_BBDelay_PANEL.kicad_pcb, DMH_BBDelay_PANEL.kicad_sch]
2025-12-29 Added tone knob
    ... by making Input Gain switch to span both channels. Also added a center Linked LED
    [DMH_BBDelay_PANEL.kicad_pcb, DMH_BBDelay_PANEL.kicad_sch]
2026-02-22 Centralized library
    [DMH_BBDelay_PANEL.kicad_pcb, DMH_BBDelay_PANEL.kicad_sch]
2026-05-27 KiCad 10
    [DMH_BBDelay_PANEL.kicad_pcb, DMH_BBDelay_PANEL.kicad_sch]
2026-06-28 Replaced Clock Sync with Inhibit input and Range
    [DMH_BBDelay_PANEL_clk.kicad_pcb, DMH_BBDelay_PANEL_clk.kicad_sch]
2026-06-28 Started main PCB project
    [Core_Circuit.kicad_sch, DMH_BBDelay_PCB_Main.kicad_pcb, DMH_BBDelay_PCB_Main.kicad_sch, Inputs_and_Outputs.kicad_sch, Power.kicad_sch]
2026-07-14 Fixed panel ground plane
    [DMH_BBDelay_PANEL.kicad_pcb]
2026-07-15 Started designing schematic
    [Attenuverters.kicad_sch, Core_Circuit.kicad_sch, DMH_BBDelay_PCB_Main.kicad_sch, Inputs_and_Outputs.kicad_sch, Power.kicad_sch, VCA_DiffAmp_SM_Mk2_H.kicad_sch]
2026-07-15 Schematic in progress
    [Attenuverters.kicad_sch, Core_Circuit.kicad_sch, VCA_DiffAmp_SM_Mk2_H.kicad_sch]
2026-07-17 Schematic in progress
    Next is implementation of Channel B, CV Linking and Ping-Pong mode
    [Attenuverters.kicad_sch, Core_Circuit.kicad_sch, DMH_BBDelay_PCB_Main.kicad_sch, Inputs_and_Outputs.kicad_sch, Power.kicad_sch, VCA_DiffAmp_SM_Mk2_H.kicad_sch, VC_Cross_Fader_SM_H.kicad_sch]
2026-07-18 Implemented Link switch in schematic
    [Attenuverters.kicad_sch, Core_Circuit_A.kicad_sch, Core_Circuit_B.kicad_sch, DMH_BBDelay_PCB_Main.kicad_sch, VCA_DiffAmp_SM_Mk2_H.kicad_sch, VC_Cross_Fader_SM_H.kicad_sch]
2026-07-18 Schematic in progress
    Added AC coupling to inputs
    Buffered wet outputs
    [Core_Circuit_A.kicad_sch, Core_Circuit_B.kicad_sch]
2026-07-19 Implemented Ping Pong funtion
    [Core_Circuit_A.kicad_sch, Core_Circuit_B.kicad_sch]
2026-07-19 Implemented tone control
    [Attenuverters.kicad_sch, Core_Circuit_A.kicad_sch, Core_Circuit_B.kicad_sch, DMH_BBDelay_PCB_Main.kicad_sch, Power.kicad_sch, Tone_Control.kicad_sch, Tone_Control_A.kicad_sch, Tone_Control_B.kicad_sch]
2026-07-19 Re-implemented Ping Pong mode with CD4053
    [Core_Circuit_A.kicad_sch, Core_Circuit_B.kicad_sch, Tone_Control_B.kicad_sch]
2026-07-19 Added schmit triggers to inhibt CV input paths
    [Core_Circuit_A.kicad_sch, Core_Circuit_B.kicad_sch, Inputs_and_Outputs.kicad_sch]
2026-07-19 Schmitt triggers added to Inhibt CV input paths
    [Core_Circuit_A.kicad_sch, Core_Circuit_B.kicad_sch]
2026-07-19 Added TRS jacks to IO page
    [Core_Circuit_A.kicad_sch, Core_Circuit_B.kicad_sch, Inputs_and_Outputs.kicad_sch]
2026-07-20 Switch to route Dry A to B VCXF input in PP mode
    [Core_Circuit_A.kicad_sch, Core_Circuit_B.kicad_sch]
2026-07-20 Added J200 connections in IO page
    [Core_Circuit_A.kicad_sch, Core_Circuit_B.kicad_sch, Inputs_and_Outputs.kicad_sch]
2026-07-20 Highlighted Controls PCB regions
    [Core_Circuit_A.kicad_sch, Core_Circuit_B.kicad_sch]
2026-07-22 Schematic ready for breadboarding
    [Attenuverters.kicad_sch, Core_Circuit_A.kicad_sch, Core_Circuit_B.kicad_sch, DMH_BBDelay_PCB_Main.kicad_sch, Inputs_and_Outputs.kicad_sch]
2026-07-31 Minor changes during breadboarding
    [Attenuverters.kicad_sch]
2026-08-01 Reversed mix pots polarity
    [Core_Circuit_A.kicad_sch, Core_Circuit_B.kicad_sch]
2026-08-02 Added CMOS ICs decoupling caps
    [Core_Circuit_B.kicad_sch]
2026-08-04 Moved LEDs to own page
    ... so I can add the LED control via CD4040
    [Core_Circuit_B.kicad_sch, DMH_BBDelay_PCB_Main.kicad_sch, LEDs.kicad_sch]
2026-08-06 Added clock dividers for LEDs
    [Attenuverters.kicad_sch, Core_Circuit_A.kicad_sch, Core_Circuit_B.kicad_sch, LEDs.kicad_sch]
2026-08-08 Connected blue LED to Ping Pong switch
    [Core_Circuit_B.kicad_sch, LEDs.kicad_sch]
2026-08-08 Fixed linking function
    Used idle 40106 gate to buffer clock A before injecting it into V3205 B
    [Core_Circuit_A.kicad_sch, Core_Circuit_B.kicad_sch, DMH_BBDelay_PANEL.kicad_pcb]
2026-08-10 Preparing for in and out filter designs
    [Attenuverters.kicad_sch, Core_Circuit.kicad_sch, Core_Circuit_A.kicad_sch, Core_Circuit_B.kicad_sch, DMH_BBDelay_PCB_Main_v1.kicad_pcb, DMH_BBDelay_PCB_Main_v1.kicad_sch, Inputs_and_Outputs.kicad_sch, LEDs.kicad_sch]
2026-08-12 Added input filters
    [Core_Circuit_A.kicad_sch, Core_Circuit_B.kicad_sch, Input_Filter_B.kicad_sch, Input_filter_A.kicad_sch]
2026-08-15 Added VC sallen key filter simulation
2026-08-18 Added output filter to channel A
    [Core_Circuit_A.kicad_sch]
2026-08-19 Changed input filter position in the signal chain
    [Core_Circuit_A.kicad_sch, Input_filter_A.kicad_sch]
2026-08-23 Moved input filter again
    [Core_Circuit_A.kicad_sch, Input_filter_A.kicad_sch]
2026-08-25 Added output filter to channel B
    [Core_Circuit_B.kicad_sch, Input_Filter_B.kicad_sch]
2026-08-26 Updated internal gains
    [Core_Circuit_A.kicad_sch, Core_Circuit_B.kicad_sch]
2026-08-28 Inverted time and tone control pots
    ... and added AC coupling to the outputs
    [Core_Circuit_A.kicad_sch, Core_Circuit_B.kicad_sch, Tone_Control_A.kicad_sch, Tone_Control_B.kicad_sch]
2026-09-03 Improved LEDs section
    [LEDs.kicad_sch]
2026-09-04 Improved safety of LEDs counter reset circuit
    [LEDs.kicad_sch]
2026-09-04 Preparing to design compander
    [Attenuverters.kicad_sch, Compressor_A.kicad_sch, Core_Circuit.kicad_sch, Core_Circuit_A.kicad_sch, Core_Circuit_B.kicad_sch, DMH_BBDelay_PCB_Main_v2.kicad_pcb, DMH_BBDelay_PCB_Main_v2.kicad_sch, Input_Filter_B.kicad_sch]
2026-09-05 Designed input compressor circuits
    [Compressor_B.kicad_sch, Core_Circuit_A.kicad_sch, Core_Circuit_B.kicad_sch, Tone_Control_A.kicad_sch]
2026-09-06 Designed Expander circuits
    [Compressor_A.kicad_sch, Core_Circuit_A.kicad_sch, Core_Circuit_B.kicad_sch, Expander_A.kicad_sch, Expander_B.kicad_sch]
2026-09-07 Inserted compander in Channel A path
    [Compressor_B.kicad_sch, Core_Circuit_A.kicad_sch, Core_Circuit_B.kicad_sch, Expander_A.kicad_sch, Input_filter_A.kicad_sch, Output_filter_A.kicad_sch]
2026-09-07 Inserted compander into channel B path
    [Core_Circuit_B.kicad_sch, Input_filter_A.kicad_sch, Output_filter_A.kicad_sch, Output_fllter_B.kicad_sch]
2026-09-08 Fixed mistake with expander output opamp
    [Expander_A.kicad_sch, Expander_B.kicad_sch]
2026-09-18 Adjustments during breadboarding
    [Core_Circuit_A.kicad_sch, Core_Circuit_B.kicad_sch, Input_Filter_B.kicad_sch, Input_filter_A.kicad_sch, Output_filter_A.kicad_sch, Output_fllter_B.kicad_sch]
2026-09-19 More adjustments during breadboarding
    [Input_Filter_B.kicad_sch, Input_filter_A.kicad_sch, Output_filter_A.kicad_sch, Output_fllter_B.kicad_sch]
2026-09-20 Added notes from troubleshooting
    [Compressor_A.kicad_sch, Compressor_B.kicad_sch, Core_Circuit_A.kicad_sch, Expander_A.kicad_sch, Input_Filter_B.kicad_sch, Input_filter_A.kicad_sch, Output_filter_A.kicad_sch, Output_fllter_B.kicad_sch]
2026-09-22 Simulated IO filters
    [Core_Circuit.kicad_sch, Input_Filter.kicad_pcb, Input_Filter.kicad_sch, Input_filter_A.kicad_sch, Inputs_and_Outputs.kicad_sch, Output_filter_A.kicad_sch, Power.kicad_sch]
2026-09-22 Fixed issue with SPICE model
    [Input_Filter.kicad_sch, Input_filter_A.kicad_sch, Output_filter_A.kicad_sch]
2026-09-26 Finished compander simulations
    [Core_Circuit_A.kicad_sch]
2026-09-26 Tweaked compander
    [Core_Circuit_A.kicad_sch, Core_Circuit_B.kicad_sch, Expander_A.kicad_sch, Expander_B.kicad_sch]
2026-09-27 Scaled up components in Tone Control part
    [Compressor_A.kicad_sch, Compressor_B.kicad_sch, Core_Circuit_A.kicad_sch, Core_Circuit_B.kicad_sch, Expander_A.kicad_sch, Expander_B.kicad_sch, Input_Filter.kicad_sch, Tone_Control_A.kicad_sch]
2026-09-28 Added 10pF to Feedback VCA output stage
    [Core_Circuit_A.kicad_sch, Core_Circuit_B.kicad_sch, VCA_DiffAmp_SM_Mk2_H.kicad_sch]
2026-10-01 Simulated compressor output clamping
2026-10-01 Added clamping to compressors outputs
    [Compressor_A.kicad_sch, Compressor_B.kicad_sch, Input_filter_A.kicad_sch]
2026-10-01 Simulated clamping diodes inside filter
    [Input_filter_A.kicad_sch, Output_filter_A.kicad_sch, Tone_Control_A.kicad_sch, Tone_Control_B.kicad_sch]
2026-10-03 Created v3 copy
    [Attenuverters.kicad_sch, Compressor_A.kicad_sch, Compressor_B.kicad_sch, Core_Circuit.kicad_sch, Core_Circuit_A.kicad_sch, Core_Circuit_B.kicad_sch, DMH_BBDelay_PCB_Main_v3.kicad_pcb, DMH_BBDelay_PCB_Main_v3.kicad_sch]
2026-10-03 Made feedback work
    [Core_Circuit_A.kicad_sch, Core_Circuit_B.kicad_sch, Expander_A.kicad_sch, Input_filter_A.kicad_sch, VCA_DiffAmp_SM_Mk2_H.kicad_sch]
2026-10-04 Removed compander and adjusted feedback
    [Core_Circuit_A.kicad_sch, Expander_A.kicad_sch, Input_Filter.kicad_sch, Output_filter_A.kicad_sch, Output_fllter_B.kicad_sch, Tone_Control_A.kicad_sch, Tone_Control_B.kicad_sch, VCA_DiffAmp_SM_Mk2_H.kicad_sch]
2026-10-06 Tuned wet gain and added FB trimpot
    [Core_Circuit_A.kicad_sch, Tone_Control_A.kicad_sch, Tone_Control_B.kicad_sch]
2026-10-09 Synced channel A and B schematics
    ... and applied several minor improvements and optimizations.
    [Core_Circuit_A.kicad_sch, Core_Circuit_B.kicad_sch, DMH_BBDelay_PCB_Main.kicad_sch, Input_Filter_B.kicad_sch, Input_filter_A.kicad_sch, Inputs_and_Outputs.kicad_sch, Output_filter_A.kicad_sch, Output_fllter_B.kicad_sch]
2026-10-10 OpAmp ringing prevention at BBD input
    [Core_Circuit_A.kicad_sch, Core_Circuit_B.kicad_sch, Tone_Control_A.kicad_sch, Tone_Control_B.kicad_sch]
2026-10-10 Validated gains in breadboard
    [Core_Circuit_A.kicad_sch, Core_Circuit_B.kicad_sch, Tone_Control_A.kicad_sch, Tone_Control_B.kicad_sch]
2026-10-10 Added anti-ringing RC network to IF sim
    [Input_Filter.kicad_sch, Input_filter_A.kicad_sch]
2026-10-11 Added connectors for submodules
    ... and marked which components are not in Main PCB
2026-10-17 Improved channel A daisy chaining
2026-10-18 Perfected circuit with double V3205
    Next step is try quad V3205 per channel to reduce aliasing further
2026-10-18 Sent footprints to PCB editor
2026-10-23 Set S&H pulse resistor back to 6k2
2026-10-31 Added note about feedback resistor
2026-11-03 Filters bypass work in progress
2026-11-04 Filters bypass experiments
2026-11-08 Range change via BBD A1 tap
    ... instead of VCO range change via resistors and solid state switching
2026-11-09 Re-added parallel resistor to increase FB at HF
2026-11-13 Updated trace widths
